rumballd/loco-controller-pre-release/images/assembled board.jpg

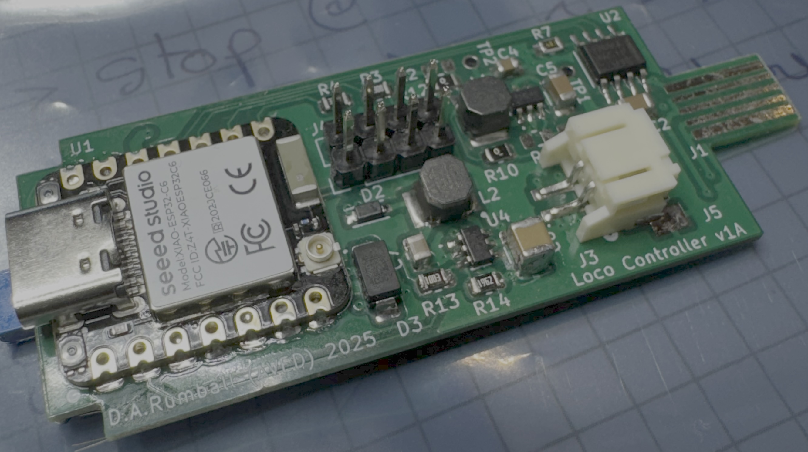
images/assembled board.jpg
