rumballd/loco-controller-pre-release/images/fitted_in_14XX.jpg

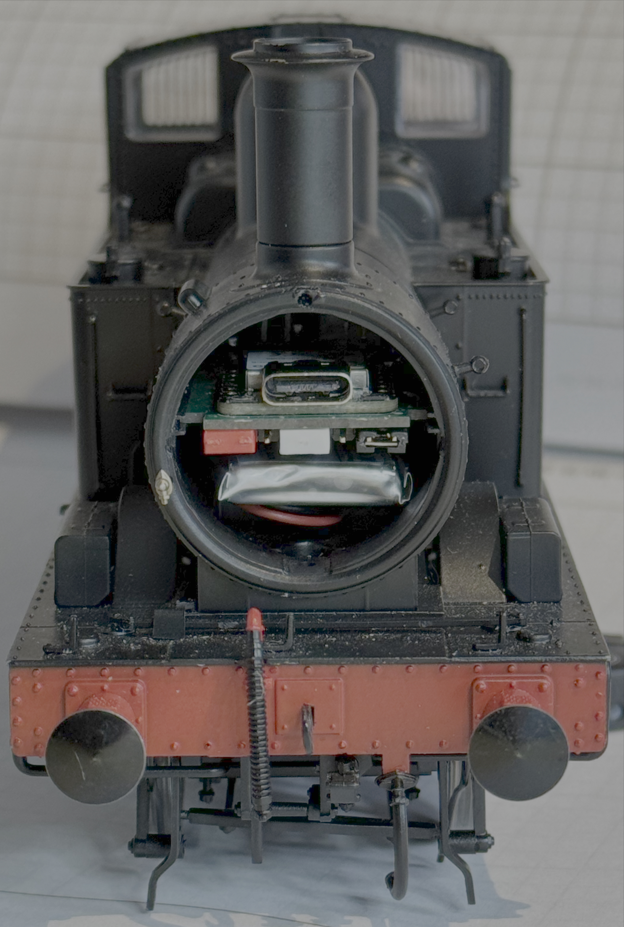
images/fitted_in_14XX.jpg
