rumballd/loco-controller-pre-release/README.md

# loco-controller-pre-release
pre-release files for the loco controller project
