rumballd/loco-controller-pre-release/read me first.pdf

Version 0.90 1st Oct 2025

### Loco Controller distribution 0.90 Oct 2025

This package should contain the following folders :-

* docs | - user notes, quick start and other guides.
* firmware | - Example ESP32-C6 firmware.
* hardware | - PCB fabrication files and component data sheets.

History
2025-10 | ver 0.90 | First release to the outside world.

Known Issues

Todo List

## Please take note of the information and warnings about the use of Li-Po batteries in Appendix 1 of the User

Notes.

This project does not contain polished or shipping quality code or hardware, so use entirely at you own risk.

The project is covered under the permissive version of the CERN Open Hardware Licence Version 2 a copy of which is part of the package.

If you have any problems with the build, find any bugs, have suggestions for features and improvements etc, please email me at lococontroller@aved.org.uk

Above all, Have Fun!

David Rumball
Constantine, UK.
