rumballd/loco-controller-pre-release/images/bottom view.png

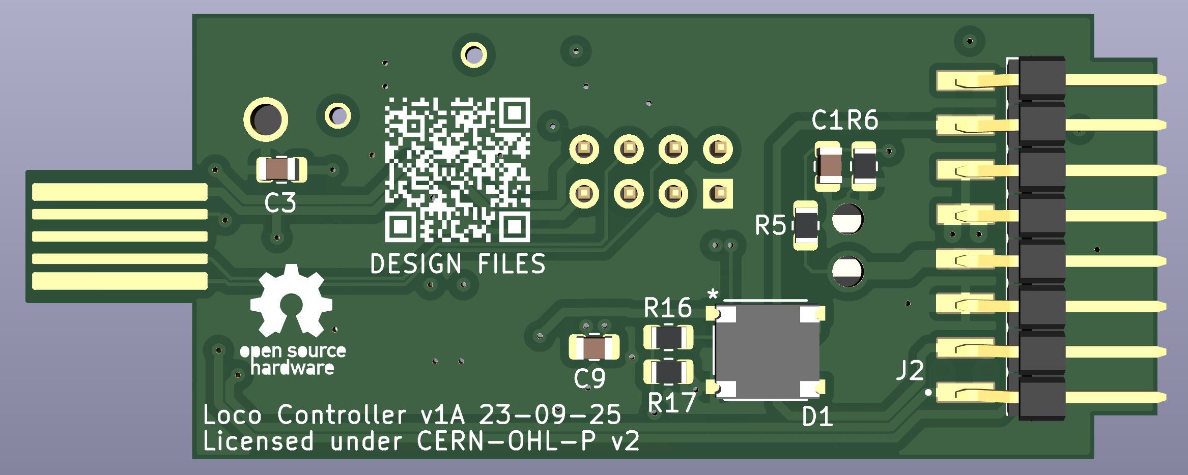
images/bottom view.png
