rumballd/loco-controller-pre-release/images/Connections - front.jpg

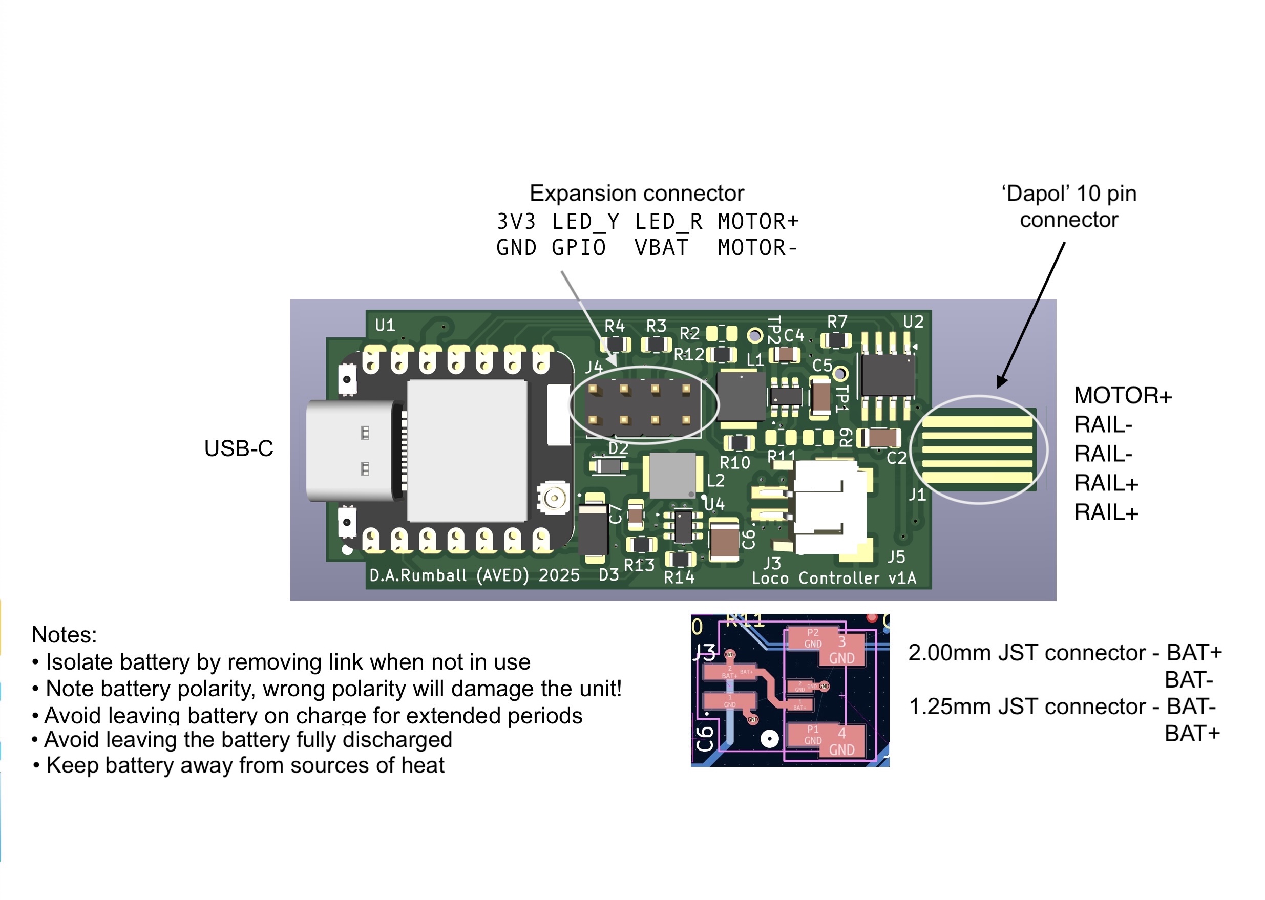
images/Connections - front.jpg
