rumballd/loco-controller-pre-release/images/Connections - rear.jpg

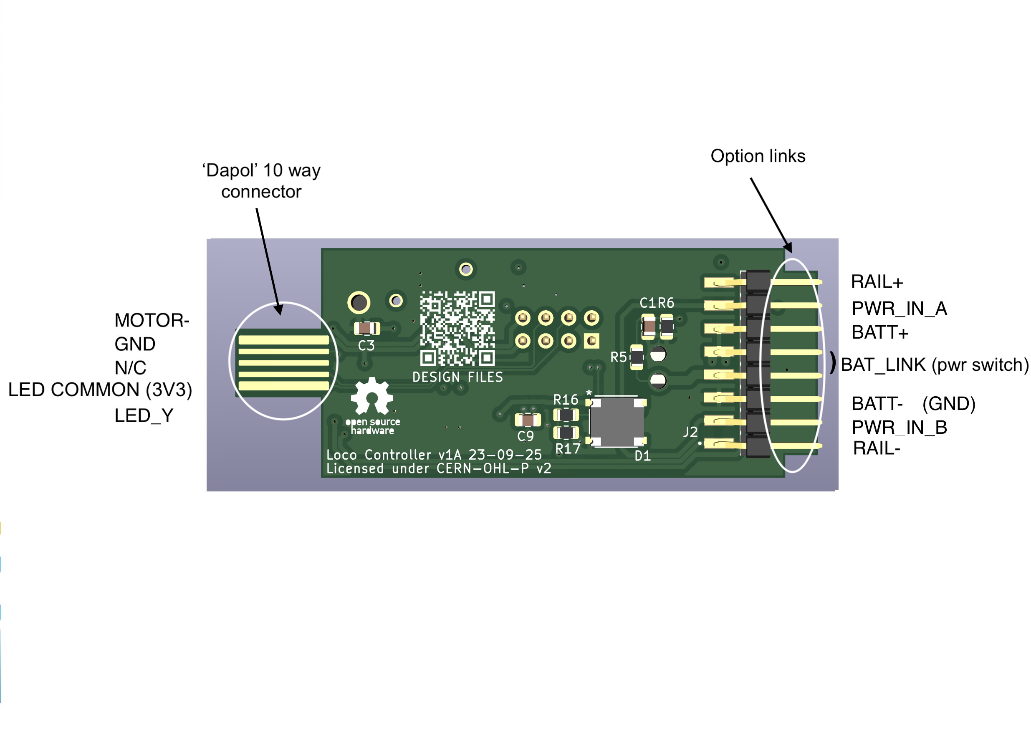
images/Connections - rear.jpg
