rumballd/loco-controller-pre-release/images/controller_plus_battery.jpg

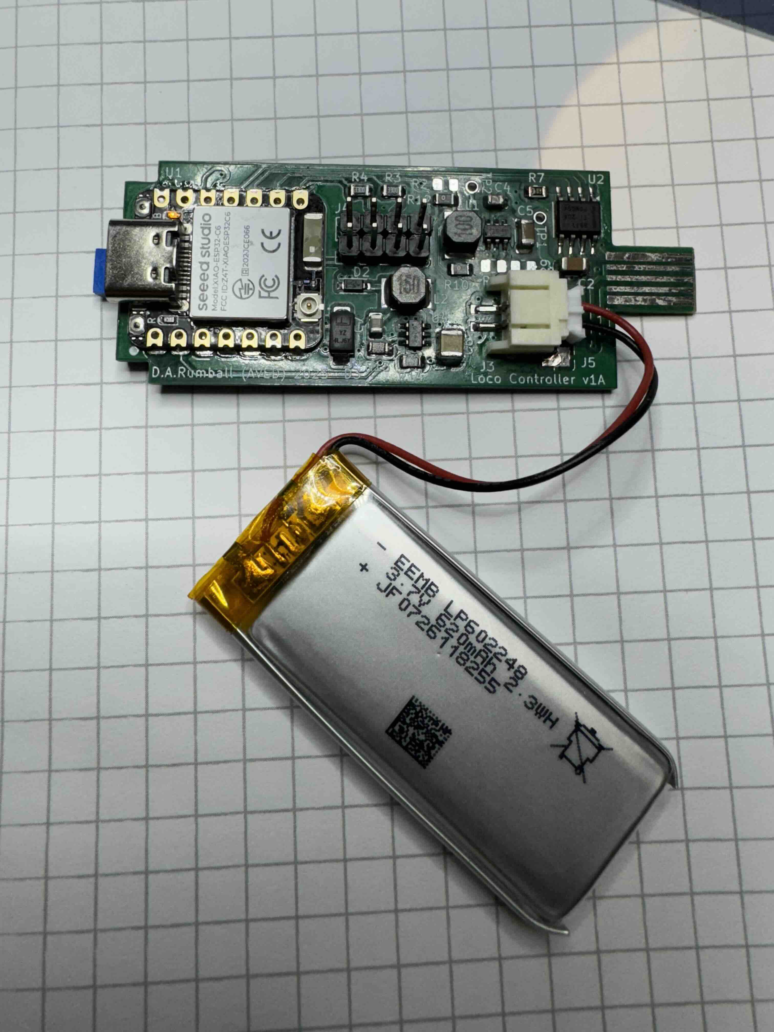
images/controller_plus_battery.jpg
