rumballd/loco-controller-pre-release/images/fitted_in_B4.jpg

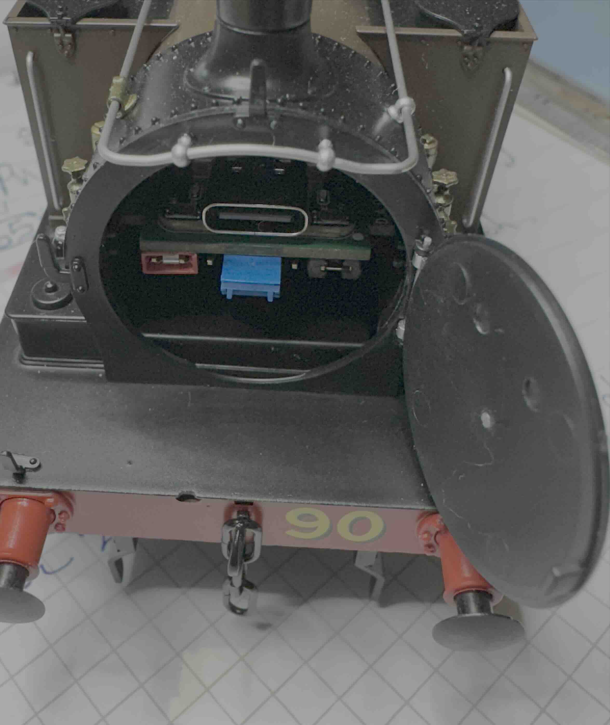
images/fitted_in_B4.jpg
