rumballd/loco-controller-pre-release/images/general view.png

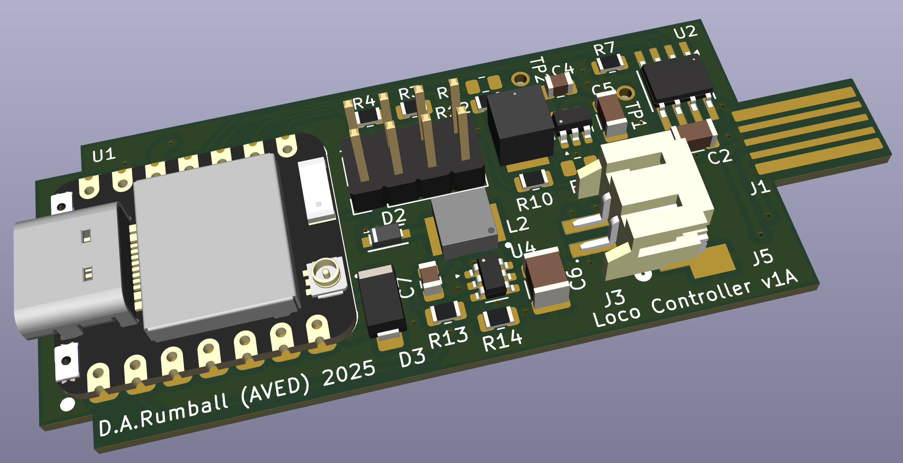
images/general view.png
