rumballd/loco-controller-pre-release/images/simple control UI.jpeg

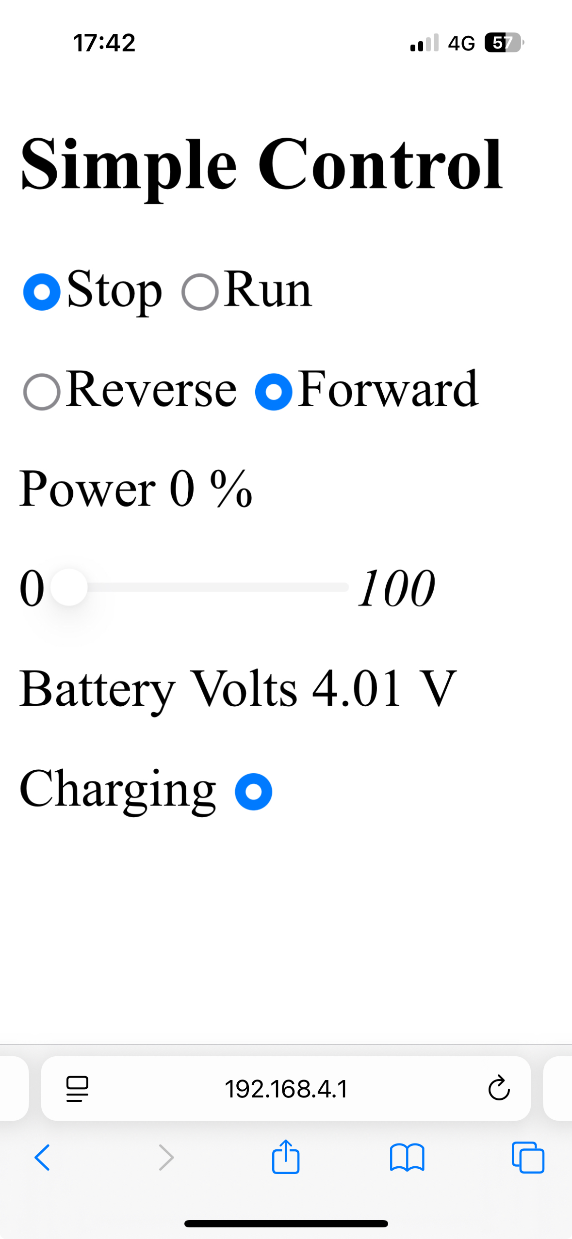
images/simple control UI.jpeg
