rumballd/loco-controller-pre-release/images/top view.png

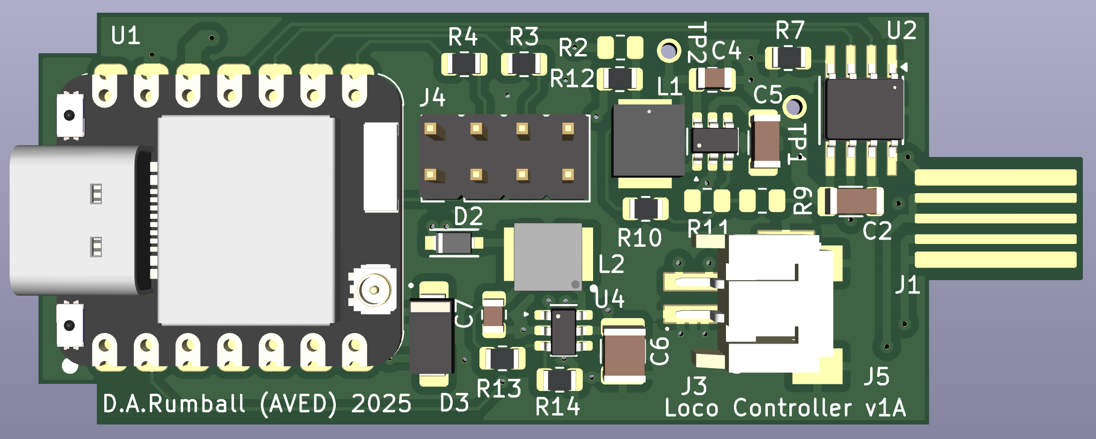
images/top view.png
