rumballd/loco-controller-pre-release/images/loco_decoder_v0.2.step

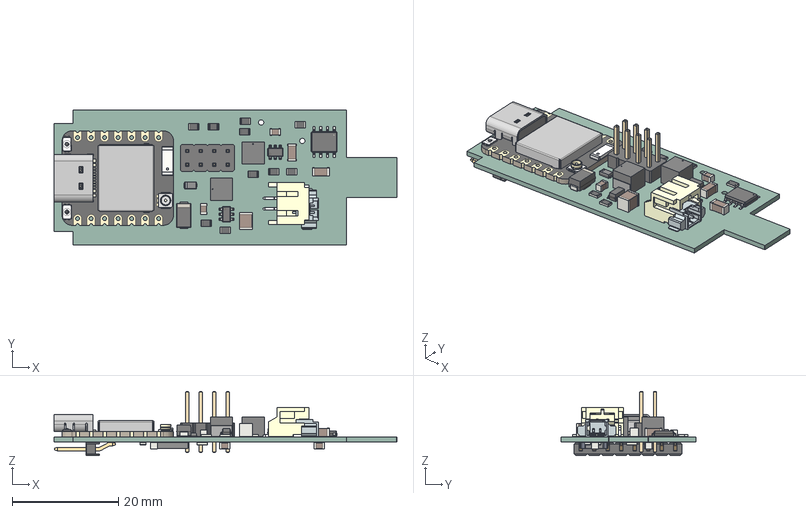
[picture p16: CAD file, 2025-09-30]
images/loco_decoder_v0.2.step
64.5 x 25.4 x 12.1 mm
R_0805_2012Metric x 14
SOT-23-6 x 2
kicad_embedded_4268D40089215B1AC33364D5905491C9 x 2
BOSS-EXTRUDE14_8_
BOSS-EXTRUDE7_4_
BOSS-EXTRUDE7_3_
BOSS-EXTRUDE14_4_
BOSS-EXTRUDE14_2_
BOSS-EXTRUDE14_11_
BOSS-EXTRUDE7_7_
BOSS-EXTRUDE14_9_
BOSS-EXTRUDE14_3_
BOSS-EXTRUDE14_7_
MIRROR2
BOSS-EXTRUDE14_5_
BOSS-EXTRUDE14_12_
BOSS-EXTRUDE7_8_
BOSS-EXTRUDE7_1_
BOSS-EXTRUDE14_10_
BOSS-EXTRUDE7_9_
BOSS-EXTRUDE14_6_
BOSS-EXTRUDE14_1_
BOSS-EXTRUDE7_6_
BOSS-EXTRUDE7_2_
CUT-EXTRUDE5
BOSS-EXTRUDE7_5_
U.FL Connector v1
Shield
SKTAAAE010 v1 x 2
KH5220-A36 (Ceramic Antenna) v2
Texas_HTSOP-8-1EP_3.9x4.9mm_P1.27mm_EP2.85x4.9mm_Mask2.4x3.1mm_ ThermalVias
C_1210_3225Metric
D_SMA
C_1206_3216Metric x 2
C_0805_2012Metric x 5
PinHeader_2x04_P2.54mm_Vertical
terminals
logo
kicad_embedded_1D2A0216B19EBB82418A5B4AF2BA824B
kicad_embedded_DDCFF2373EAE1CF9C5861DB1AABFC711
kicad_embedded_CD2B932B5F435B6E3418D692FA3D0E84
loco-decoder-v0.2_PCB
